Jeija/WS2811LEDMatrix/board/schematic.pdf

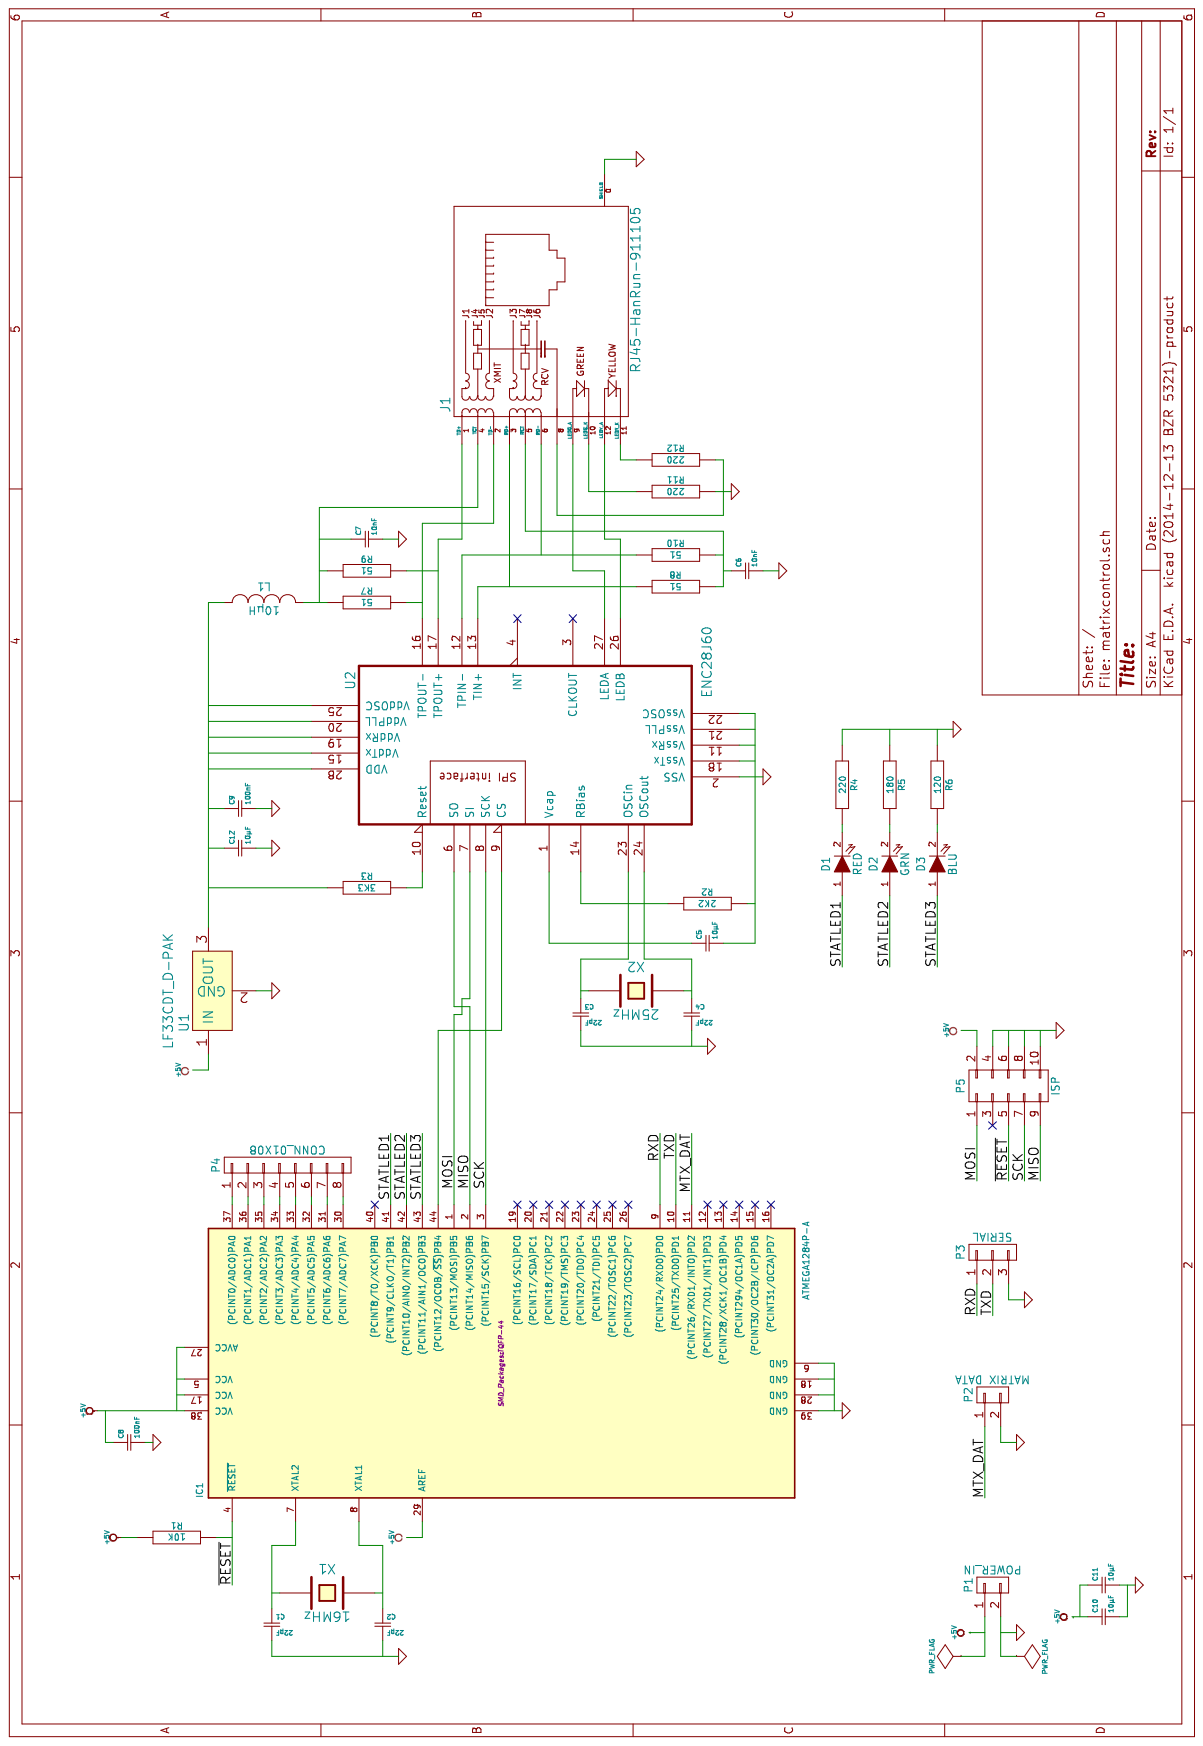
[picture p1: page 1]
