Jeija/WS2811LEDMatrix/board/matrixcontrol.kicad_pcb

## KiCad design board/matrixcontrol.kicad_pcb (2015-01-09)

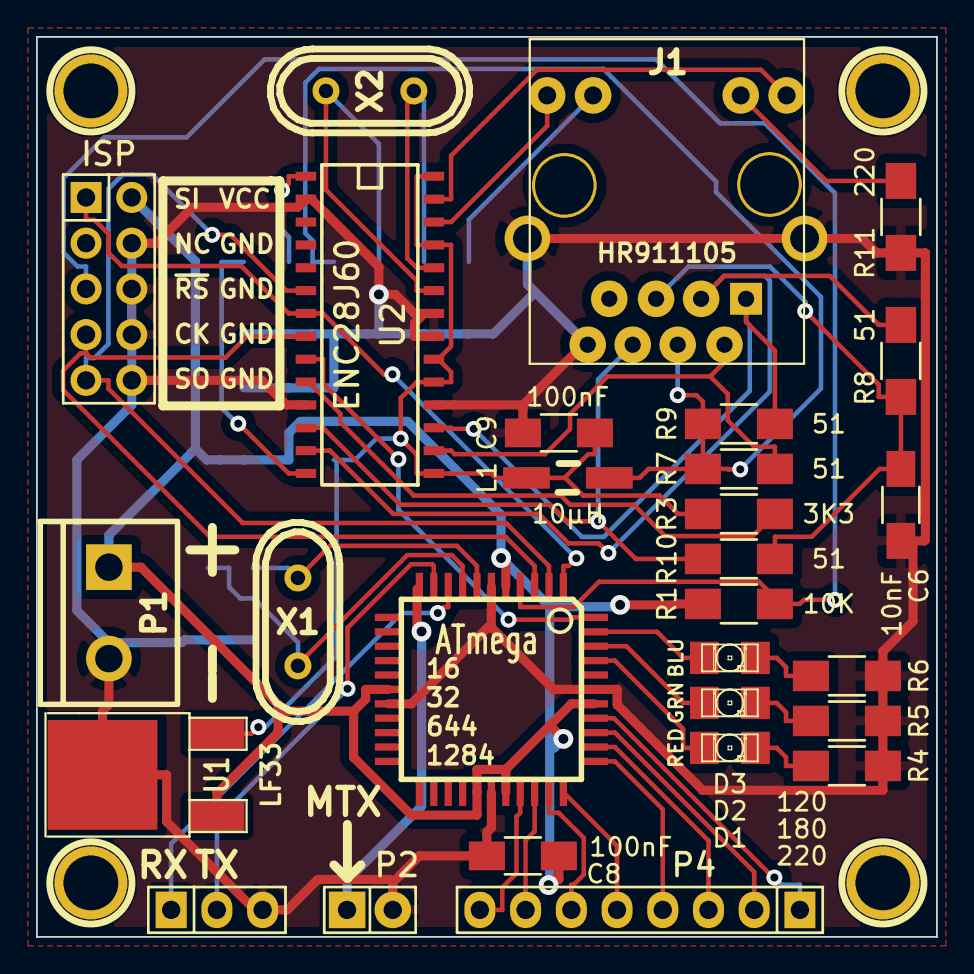
[picture p2: board matrixcontrol.kicad_pcb from above]

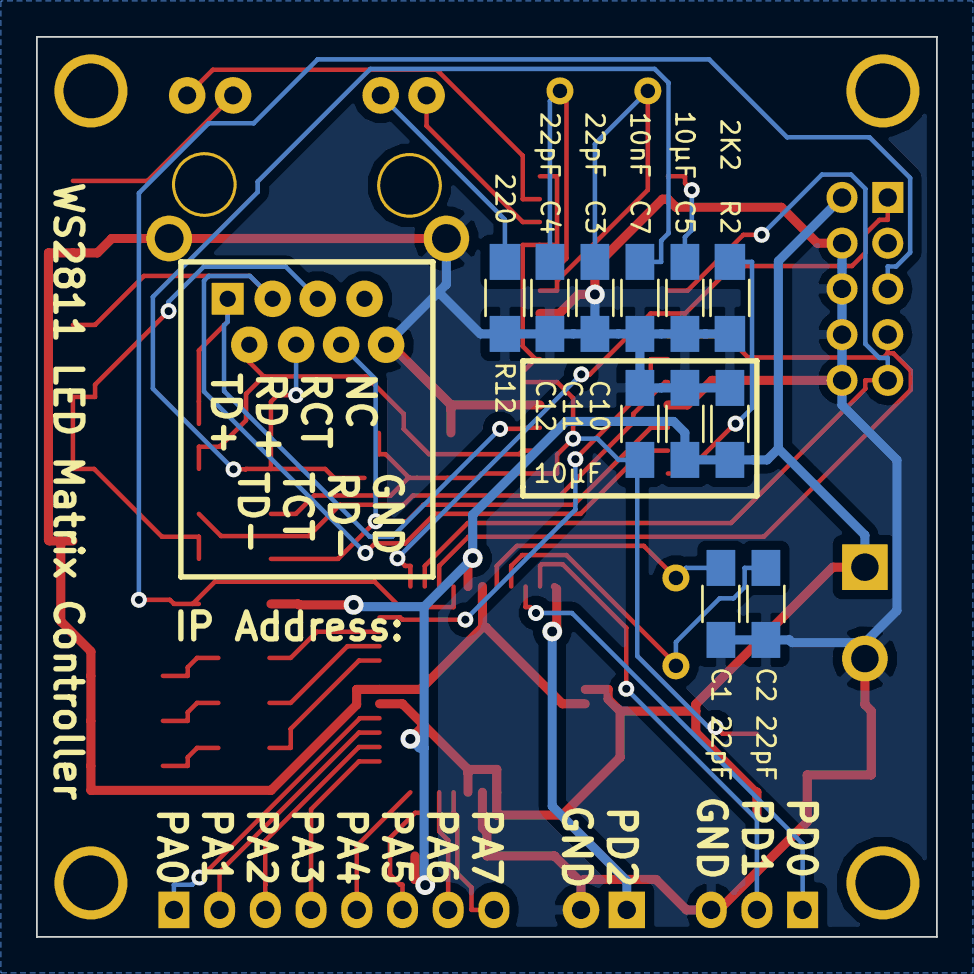
[picture p3: board matrixcontrol.kicad_pcb from below]

Board: 2 copper layers, 50.0 x 50.0 mm, 43 parts (11 on the bottom side), 42 nets.

Parts:
C1, C2, C3, C4: 22pF; C_1206_HandSoldering
C5, C10, C11, C12: 10µF; C_1206_HandSoldering
C6, C7: 10nF; C_1206_HandSoldering
C8, C9: 100nF; C_1206_HandSoldering
D1: RED; LED-1206
D2: GRN; LED-1206
D3: BLU; LED-1206
IC1: ATmega; TQFP-44
ISP: ISP; Pin_Header_Straight_2x05
J1: HR911105; HR911105_RJ45
L1: 10µH; Choke_SMD_1206_Handsoldering
MOUNT1, MOUNT2, MOUNT3, MOUNT4: 1pin
P1: POWER_IN; bornier2
P2: MATRIX DATA; Pin_Header_Straight_1x02
P3: SERIAL; Pin_Header_Straight_1x03
P4: CONN_01X08; Pin_Header_Straight_1x08
R1: 10K; R_1206_HandSoldering
R2: 2K2; R_1206_HandSoldering
R3: 3K3; R_1206_HandSoldering
R4, R11, R12: 220; R_1206_HandSoldering
R5: 180; R_1206_HandSoldering
R6: 120; R_1206_HandSoldering
R7, R8, R9, R10: 51; R_1206_HandSoldering
U1: LF33; DPAK-2
U2: ENC28J60; SOIC-28
X1: 16MHz; Crystal_HC49-U_Vertical
X2: 25MHz; Crystal_HC49-U_Vertical

Connections:
+5V: C8.1, C10.1, C11.1, IC1.5, IC1.17, IC1.27, IC1.29, IC1.38, ISP.2, P1.1, R1.1, U1.1
/MISO: IC1.2, ISP.9, U2.6
/MOSI: IC1.1, ISP.1, U2.7
/MTX_DAT: IC1.11, P2.1
/RXD: IC1.9, P3.1
/SCK: IC1.3, ISP.7, U2.8
/STATLED1: D1.1, IC1.41
/STATLED2: D2.1, IC1.42
/STATLED3: D3.1, IC1.43
/TXD: IC1.10, P3.2
/~RESET: IC1.4, ISP.5, R1.2
GND: C1.2, C2.2, C3.2, C4.2, C5.2, C6.2, C7.2, C8.2, C9.2, C10.2, C11.2, C12.2, IC1.6, IC1.18, IC1.28, IC1.39, ISP.4, ISP.6, ISP.8, ISP.10, J1.0, J1.8, P1.2, P2.2, P3.3, R2.2, R4.1, R5.1, R6.1, R11.2, R12.2, U1.2, U2.2, U2.11, U2.18, U2.21, U2.22
unnamed: C1.1, IC1.7, X1.1
unnamed: C2.1, IC1.8, X1.2
unnamed: C3.1, U2.23, X2.1
unnamed: C4.1, U2.24, X2.2
unnamed: C5.1, U2.1
unnamed: C6.1, J1.5, R8.2, R10.2
unnamed: C7.1, J1.4, L1.2, R7.1, R9.1
unnamed: C9.1, C12.1, L1.1, R3.1, U1.3, U2.15, U2.19, U2.20, U2.25, U2.28
unnamed: D1.2, R4.2
unnamed: D2.2, R5.2
unnamed: D3.2, R6.2
unnamed: IC1.30, P4.8
unnamed: IC1.31, P4.7
unnamed: IC1.32, P4.6
unnamed: IC1.33, P4.5
unnamed: IC1.34, P4.4
unnamed: IC1.35, P4.3
unnamed: IC1.36, P4.2
unnamed: IC1.37, P4.1
unnamed: IC1.44, U2.9
unnamed: J1.1, R9.2, U2.17
unnamed: J1.2, R7.2, U2.16
unnamed: J1.3, R8.1, U2.13
unnamed: J1.6, R10.1, U2.12
unnamed: J1.9, U2.27
unnamed: J1.10, R11.1
unnamed: J1.11, R12.1
unnamed: J1.12, U2.26
unnamed: R2.1, U2.14
unnamed: R3.2, U2.10
