Jeija/WS2811LEDMatrix/firmware/util.h

#ifndef _UTIL_H
#define _UTIL_H

// Write / modify bit in byte / register
#define sbi(ADDR, BIT) ((ADDR |=  (1<<BIT)))
#define cbi(ADDR, BIT) ((ADDR &= ~(1<<BIT)))
#define gbi(ADDR, BIT) ((ADDR &   (1<<BIT)))
#define tbi(ADDR, BIT) ((ADDR ^=  (1<<BIT)))

#endif
