Jeija/WS2811LEDMatrix/(commit log)

2014-11-15 Initial Upload - Working client and emulator without firmware or schematics
    [lookup.csv]
2014-11-30 Remove unused input socket setup
2015-01-09 Add AVR ATMega16 + ENC28J60 board design and firmware
    [matrixcontrol.kicad_pcb, matrixcontrol.sch]
2015-01-09 README: Add link to LED pixels
2015-01-10 Add pdf schematic
2015-01-11 Add node.js client protocol implementation and example code for it
    [lookup.csv]
2015-01-13 Add MultiMatrix, it allows creating combinations of multiple matrices in a global environment to put together larger animations on multiple matrices. Adapt sample to use that feature.
2015-01-13 Add example of live, user-controlled animations using a HTML + JavaScript control panel and socket.io
2015-01-23 Update panel arrangement to 4 LED matrices, fix bug in sky noise animation to adapt to it
2015-01-24 Add pixel art animation and add a lot of sample images
2015-01-30 Add multiple noise animations * Darknoise: Onecolor-black noise * Heatnoise: Rainbow colored noise, smooth transitions * Rainbowdash: Rainbow-colored noise, with preset colors
2015-01-30 Add animation to display videos rendered to 20x10 images on the LED Matrix
    The video has to be encoded into png frames, e.g. by ffmpeg and will be loaded to the
    RAM as a whole when starting the animation
2015-02-02 Bugfix: Video animation now allows for longer videos, no more frame limit
